Digim00n/BananaSchplit/BananaSchplit.kicad_pcb

## KiCad design BananaSchplit.kicad_pcb (2021-11-08)

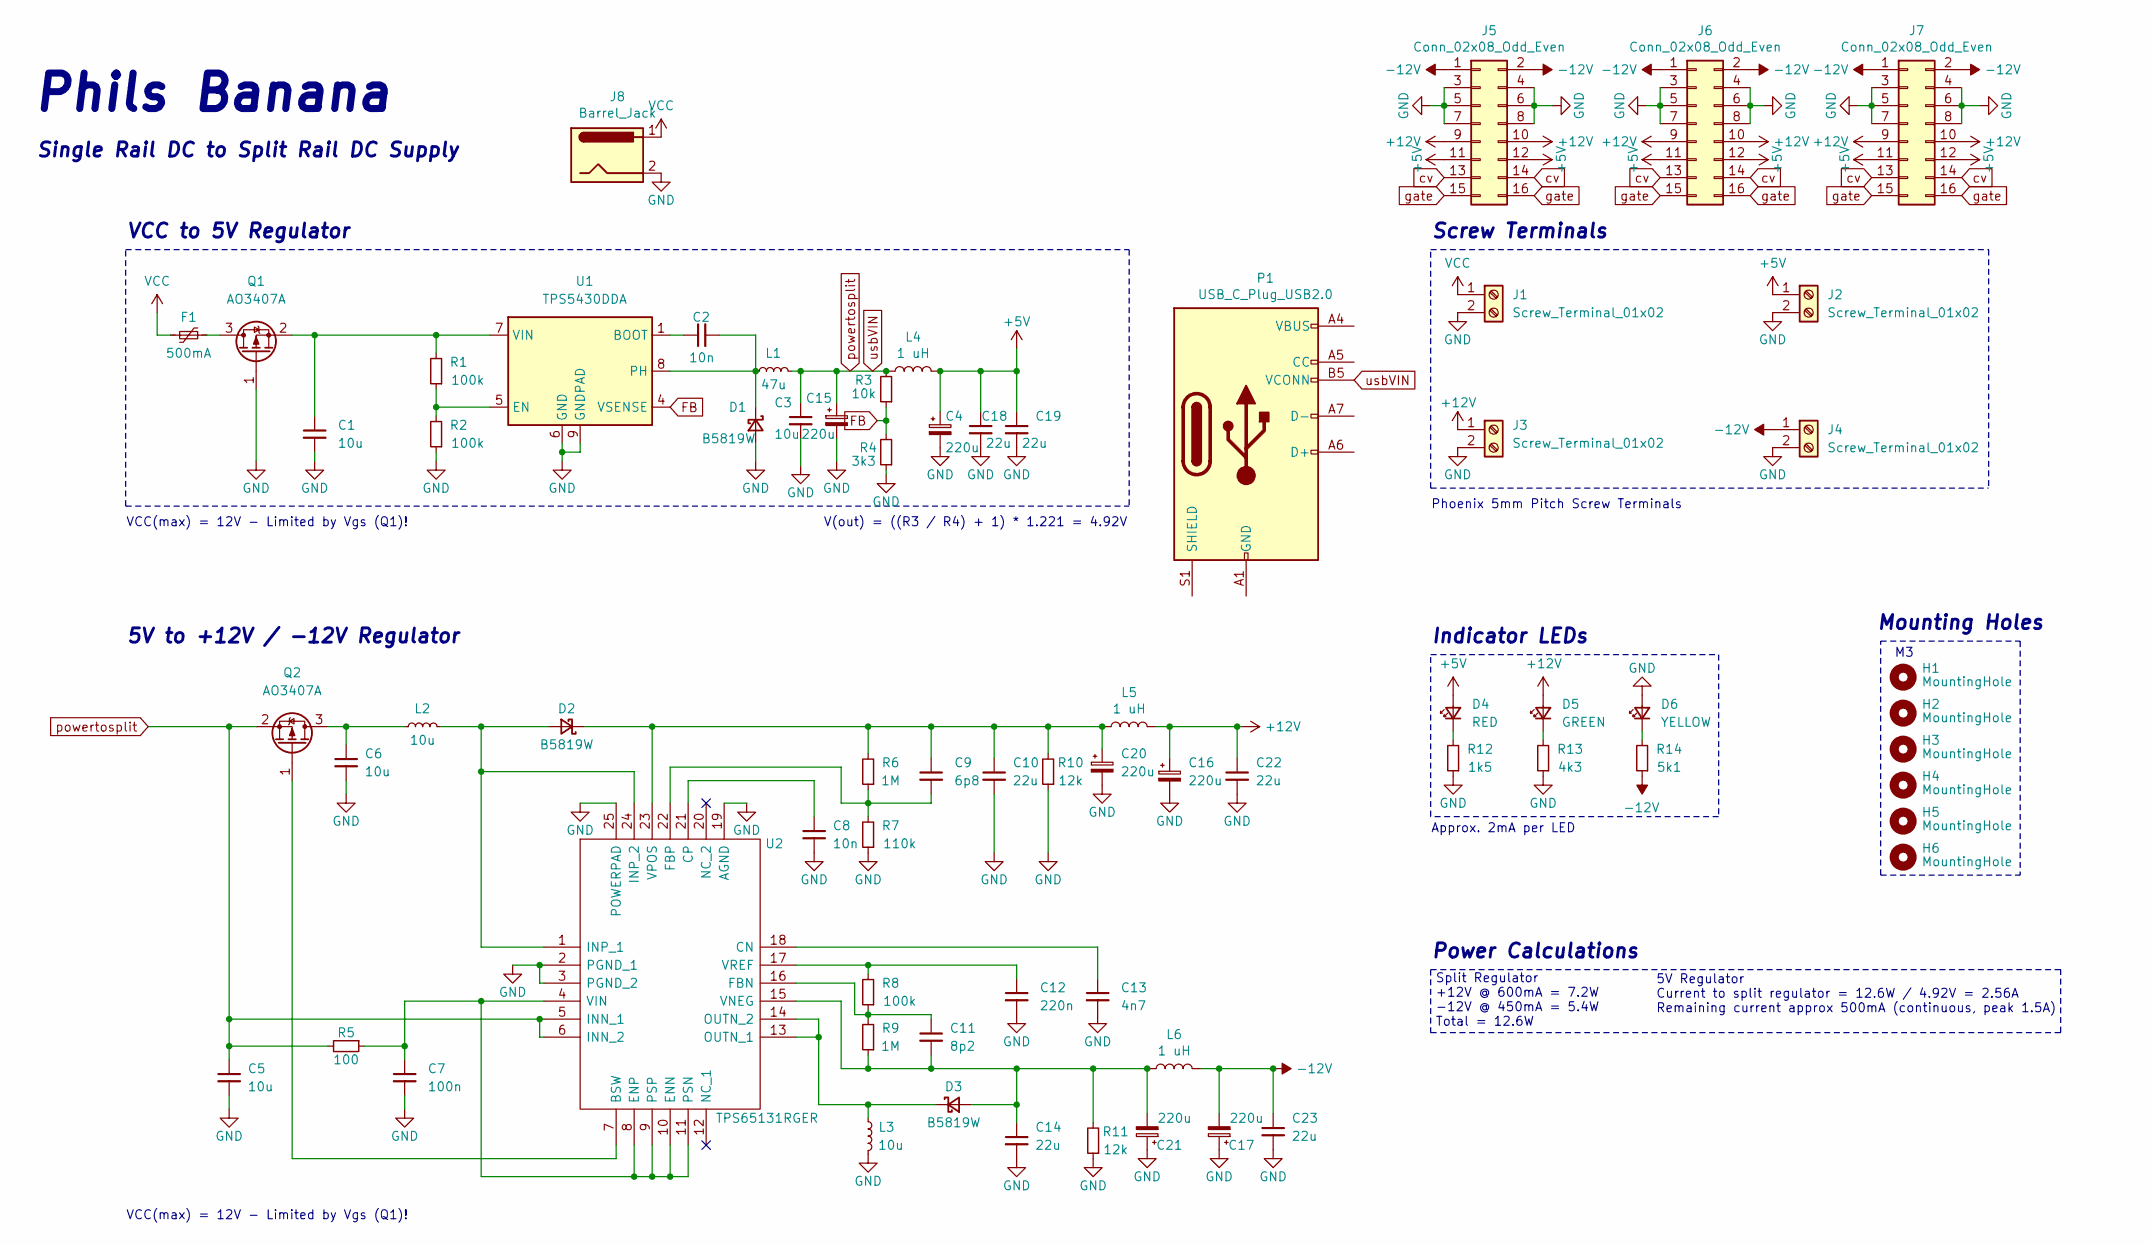
[picture p1: schematic BananaSchplit.sch, Banana Schplit]

Parts:
C1, C3, C5, C6: 10u; C_1206_3216Metric; LCSC Part # C13585
C2, C8: 10n; C_0603_1608Metric; LCSC Part # C57112
C4, C15, C16, C17, C20, C21: 220u; CP_Elec_6.3x7.7; LCSC Part # C127327
C7: 100n; C_0603_1608Metric; LCSC Part # C14663
C9: 6p8; C_0603_1608Metric; LCSC Part # C1679
C10, C14, C18, C19, C22, C23: 22u; C_0805_2012Metric; LCSC Part # C45783
C11: 8p2; C_0603_1608Metric; LCSC Part # C1685
C12: 220n; C_0603_1608Metric; LCSC Part # C21120
C13: 4n7; C_0603_1608Metric; LCSC Part # C53987
D1, D2, D3: B5819W; D_SOD-123; LCSC Part # C8598
D4: RED; LED_0805_2012Metric; LCSC Part # C84256
D5: GREEN; LED_0805_2012Metric; LCSC Part # C2297
D6: YELLOW; LED_0805_2012Metric; LCSC Part # C2296
F1: 500mA; Fuse_1812_4532Metric; LCSC Part # C151168
H1, H2, H3, H4, H5, H6: MountingHole; MountingHole_3.2mm_M3
J1, J2, J3, J4: Screw_Terminal_01x02; TerminalBlock_Phoenix_PT-1,5-2-5.0-H_1x02_P5.00mm_Horizontal
J5, J6, J7: Conn_02x08_Odd_Even; PinSocket_2x08_P2.54mm_Vertical
J8: Barrel_Jack; BarrelJack_Horizontal
L1: 47u; SWRB1204S; LCSC Part # C169398
L2, L3: 10u; L_Sunlord_MWSA0518_5.4x5.2mm; LCSC Part # C139506
L4, L5, L6: 1 uH; TYS60281R0N-10
P1: USB_C_Plug_USB2.0; USB_C_Receptacle_HRO_TYPE-C-31-M-12
Q1, Q2: AO3407A; SOT-23; LCSC Part # C347478
R1, R2, R8: 100k; R_0603_1608Metric; LCSC Part # C25803
R3: 10k; R_0603_1608Metric; LCSC Part # C25804
R4: 3k3; R_0603_1608Metric; LCSC Part # C22978
R5: 100; R_0603_1608Metric; LCSC Part # C22775
R6, R9: 1M; R_0603_1608Metric; LCSC Part # C22935
R7: 110k; R_0603_1608Metric; LCSC Part # C25805
R10, R11: 12k; R_0603_1608Metric; LCSC Part # C22790
R12: 1k5; R_0603_1608Metric; LCSC Part # C22843
R13: 4k3; R_0603_1608Metric; LCSC Part # C23159
R14: 5k1; R_0603_1608Metric; LCSC Part # C23186
U1: TPS5430DDA; TI_SO-PowerPAD-8_ThermalVias; LCSC Part # C9864
U2: TPS65131RGER; QFN-24-1EP_4x4mm_P0.5mm_EP2.6x2.6mm; Mouser2 Part Number 595-TPS65131RGET

Connections:
+5V: C4.1, C18.1, C19.1, D4.2 (A), J2.1, J5.11, J5.12, J6.11, J6.12, J7.11, J7.12, L4.2
+12V: C16.1, C22.1, D5.2 (A), J3.1, J5.9, J5.10, J6.9, J6.10, J7.9, J7.10, L5.2
-12V: C17.2, C23.1, J4.1, J5.1, J5.2, J6.1, J6.2, J7.1, J7.2, L6.2, R14.1
FB: R3.1, R4.2, U1.4 (VSENSE)
GND: C1.2, C3.2, C4.2, C5.2, C6.2, C7.2, C8.2, C10.2, C12.2, C13.2, C14.2, C15.2, C16.2, C17.1, C18.2, C19.2, C20.2, C21.1, C22.2, C23.2, D1.2 (A), D6.2 (A), J1.2, J2.2, J3.2, J4.2, J5.3, J5.4, J5.5, J5.6, J5.7, J5.8, J6.3, J6.4, J6.5, J6.6, J6.7, J6.8, J7.3, J7.4, J7.5, J7.6, J7.7, J7.8, J8.2, L3.2, Q1.1 (G), R2.1, R4.1, R7.1, R10.1, R11.1, R12.1, R13.1, U1.6 (GND), U1.9 (GNDPAD), U2.2 (PGND_1), U2.3 (PGND_2), U2.19 (AGND), U2.25 (POWERPAD)
unnamed: C1.1, Q1.2 (S), R1.2, U1.7 (VIN)
unnamed: C2.1, U1.1 (BOOT)
unnamed: C2.2, D1.1 (K), L1.1, U1.8 (PH)
unnamed: C6.1, L2.1, Q2.3 (D)
unnamed: C7.1, R5.1, U2.4 (VIN), U2.8 (ENP), U2.9 (PSP), U2.10 (ENN), U2.11 (PSN)
unnamed: C8.1, U2.21 (CP)
unnamed: C9.2, R6.1, R7.2, U2.22 (FBP)
unnamed: C9.1, C10.1, C20.1, D2.1 (K), L5.1, R6.2, R10.2, U2.23 (VPOS)
unnamed: C11.1, R8.1, R9.2, U2.16 (FBN)
unnamed: C11.2, C14.1, C21.2, D3.2 (A), L6.1, R9.1, R11.2, U2.15 (VNEG)
unnamed: C12.1, R8.2, U2.17 (VREF)
unnamed: C13.1, U2.18 (CN)
unnamed: D2.2 (A), L2.2, U2.1 (INP_1), U2.24 (INP_2)
unnamed: D3.1 (K), L3.1, U2.13 (OUTN_1), U2.14 (OUTN_2)
unnamed: D4.1 (K), R12.2
unnamed: D5.1 (K), R13.2
unnamed: D6.1 (K), R14.2
unnamed: F1.1, Q1.3 (D)
unnamed: P1.A1 (GND), P1.A12 (GND), P1.B1 (GND), P1.B12 (GND)
unnamed: P1.A4 (VBUS), P1.A9 (VBUS), P1.B4 (VBUS), P1.B9 (VBUS)
unnamed: Q2.1 (G), U2.7 (BSW)
unnamed: R1.1, R2.2, U1.5 (EN)
VCC: F1.2, J1.1, J8.1
cv: J5.13, J5.14, J6.13, J6.14, J7.13, J7.14
gate: J5.15, J5.16, J6.15, J6.16, J7.15, J7.16
powertosplit: C3.1, C5.1, C15.1, L1.2, L4.1, P1.B5 (VCONN), Q2.2 (S), R3.2, R5.2, U2.5 (INN_1), U2.6 (INN_2)

Notes on the sheet:
VCC to 5V Regulator
5V to +12V / -12V Regulator
Screw Terminals
Indicator LEDs
Mounting Holes
Phils Banana
Single Rail DC to Split Rail DC Supply
VCC(max) = 12V - Limited by Vgs (Q1)!
V(out) = ((R3 / R4) + 1) * 1.221 = 4.92V
Phoenix 5mm Pitch Screw Terminals
Approx. 2mA per LED
Split Regulator +12V @ 600mA = 7.2W -12V @ 450mA = 5.4W Total = 12.6W
5V Regulator Current to split regulator = 12.6W / 4.92V = 2.56A Remaining current approx 500mA (continuous, peak 1.5A)
Power Calculations

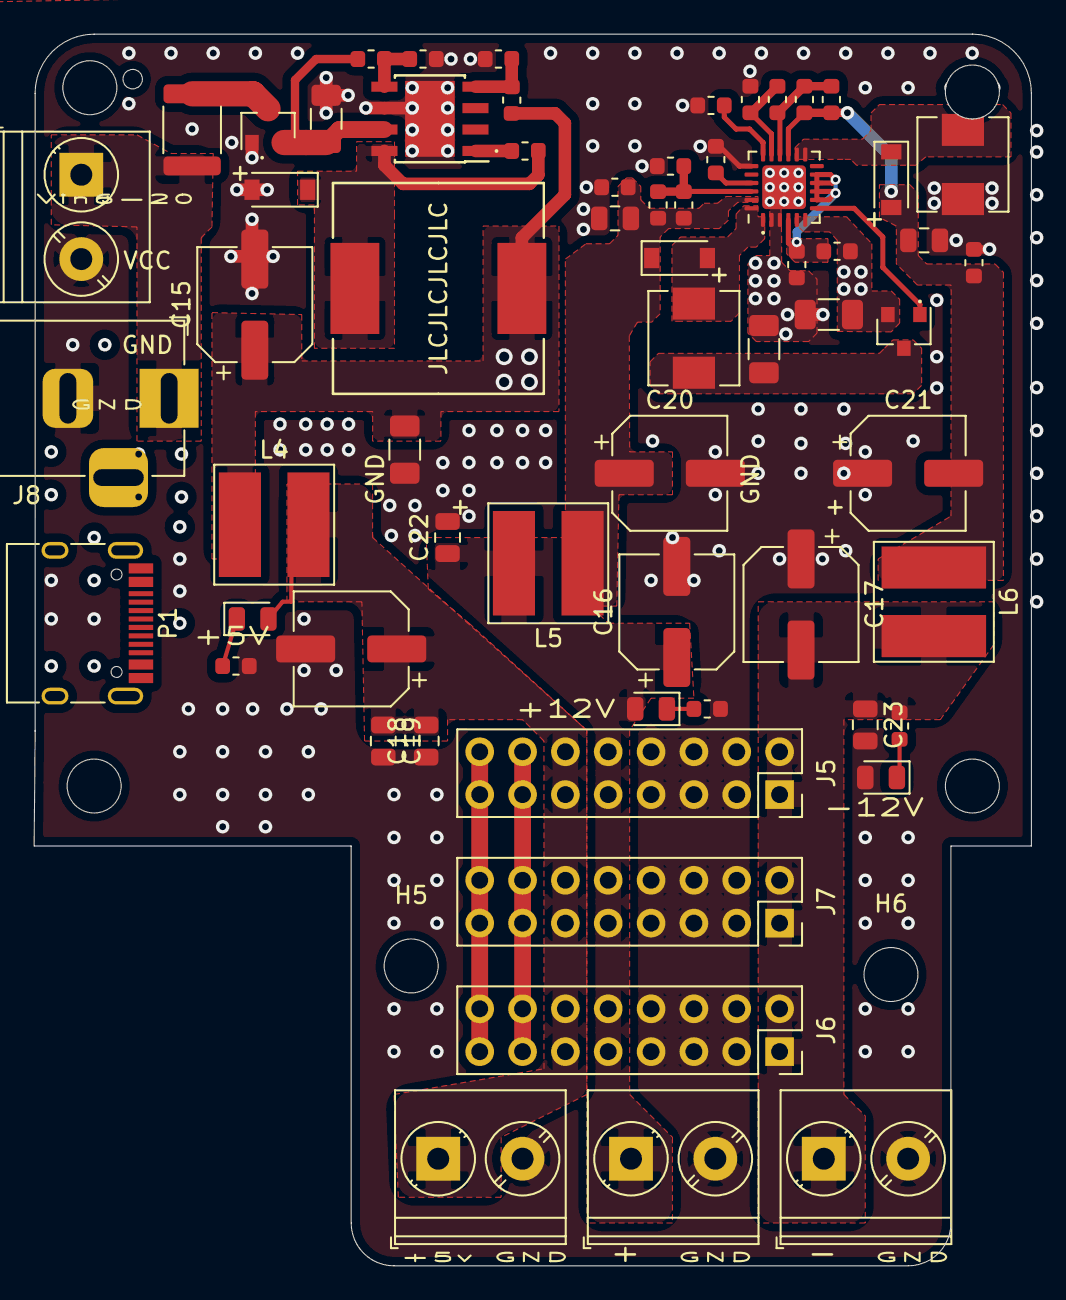
[picture p2: board BananaSchplit.kicad_pcb from above]

Board: 2 copper layers, 59.1 x 73.0 mm, 69 parts (0 on the bottom side), 31 nets.
